Ombejeanne/PEIP2_Arduino_ExploBot/README.md

# PEIP2_Arduino_ExploBot
Le projet Arduino 2018 de Michele Bona et Anthony Barna.
