Ombejeanne/PEIP2_Arduino_ExploBot/documents/specs.md

# Caractéristiques des composants utilisés 

## Arduino UNO R3

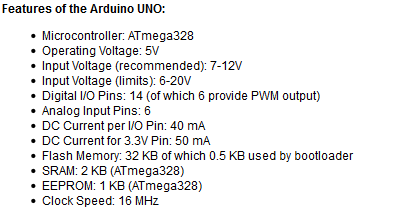
[picture p1: documents/images/Arduino UNO R3 specs.PNG]


## Commande d'entraînement de moteur à courant continu L298N 

* Alimentation intégrée : 5V
* Tension de pilotage : 7-35V
* Courant logique: 0mA-36mA 
* Tension logique: 5V 
* Courant d'entraînement: 2A 
* Tension d'entraînement: 5V-35V 
* Température de stockage: -20 à +135 
* Puissance maximum: 25W 

## Moteurs JGA 25 370

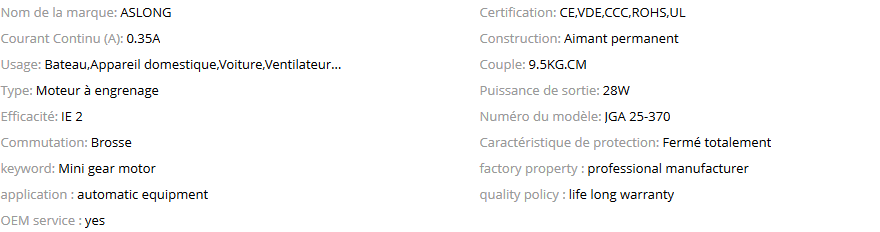
[picture p2: documents/images/moteur jga 25 370.PNG]


## Servomoteur Tower Pro MG 996R

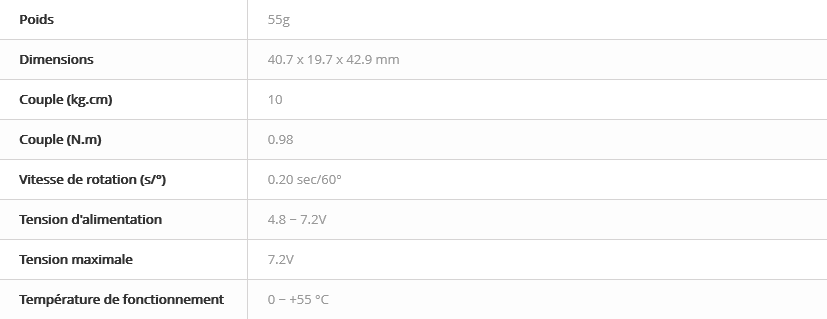
[picture p3: documents/images/Tower Pro MG 996 r.PNG]


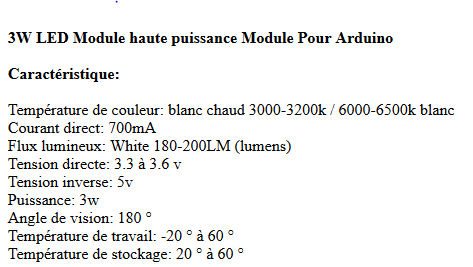
[picture p4: documents/images/LED HP 3W.PNG]
