Ombejeanne/PEIP2_Arduino_ExploBot/Rapports seances/Michele Bona.md

# Rapport Projet – Michele Bona

## 10/12/2018 – Premier jour :

* Notre groupe de projet est constitué de Michele Bona et Anthony Barna et on a aujourd’hui confirmé que notre projet sera l’ExploBot, une voiture « tout-terrain » (dans la mesure du possible) étudié pour explorer des grottes, des couloirs, les pyramides (avec lumières, caméra, détection d’obstacles, et autres à préciser plus tard).

* Je crée notre compte GitHub et lit le guide en ligne(https://guides.github.com/activities/hello-world/) pour bien comprendre comment on va s’organiser et on a récupéré une manette d’un ancien projet qui nous servira à diriger notre robot. Il faut par contre d’abord qu’on étudie comment elle marche, on a donc coupé et ressoudé les câbles de la manette qu’Anthony branchera sur sa carte Arduino pour étudier son fonctionnement.

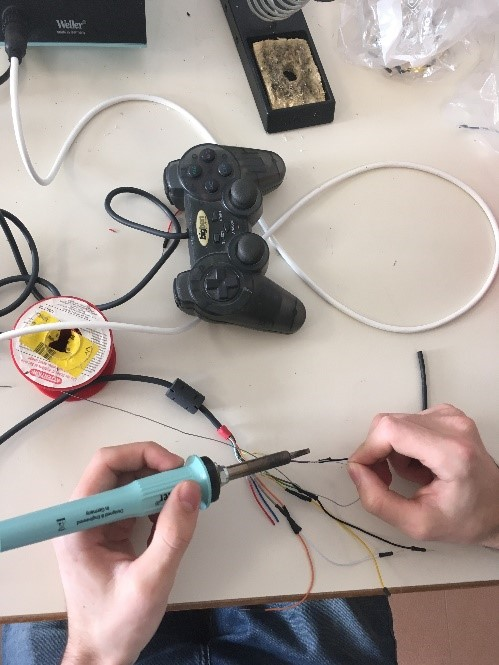
[picture p11: documents/images/ima.jpg]
Soudage cables, cf documents/images/ima.jpg

  
* Je fais des recherches sur le moteur dont on aura besoin selon le poids de notre robot, en effet on veut ajouter de nombreuses fonctionnalités à notre robot dont on n’a pas encore défini certaines donc on ne connait pas encore son poids et on doit commencer à étudier les puissances de moteurs dont on pourrait avoir besoin :

1. On s’est mit d’accord pour rester sur une base de 3 « fonctionnalités » (toutes dirigeables avec un servomoteur) : une caméra, de la lumière et un capteur de distance/d’obstacle.

2. J’ai cherché sur robotshop.com un outil de dimensionnement de moteur : https://www.robotshop.com/community/blog/show/dimensionnement-dun-moteur-dentranement
Je verrais la prochaine fois la dimension necessaire.

* Je fais notre cahier des charges avec un tableau excel, je fais les recherches pour voir ce dont j'aurais besoin pour le support et le moteur de la voiture et je vois combien de temps chaque élément du projet va prendre et je le rajoute au CDC au fur et à mesure.

## 17/12/2018 - Deuxième jour:

* J'ai été malade toute la semaine du 17 et est donc fait mes recherches pendant les vacances et ai perdu mon cahier des charges que j'ai donc refait.

* J'ai choisi les caracteristiques des moteurs nécessaire pour faire tourner nos roues en partant de l'idée que notre robot peserai au grand maximum 1kg (sachant que le servo pèse 55g, une pile de 12V environ 150g et en m'insiprant d'autres projets similaires). On cherche de plus à avoir un vehicule tout terrain, donc on sacrifie la vitesse maximale que j'ai estimé à 0.8 m/s et je choisi un assez grand rayon de roue (4cm). Et en prenant en plus en compte le fait  qu'on a 2 moteurs d'entrainement l'outil de dimensionnement de robotshop nous conseille un moteur avec un couplage de 0.1 Nm et de 2.2 W, ce qui me semble peu mais on peut dire que c'est un minimum et que plus de couplage ne nous fera pas de mal pour gravir des terrain compliqués.

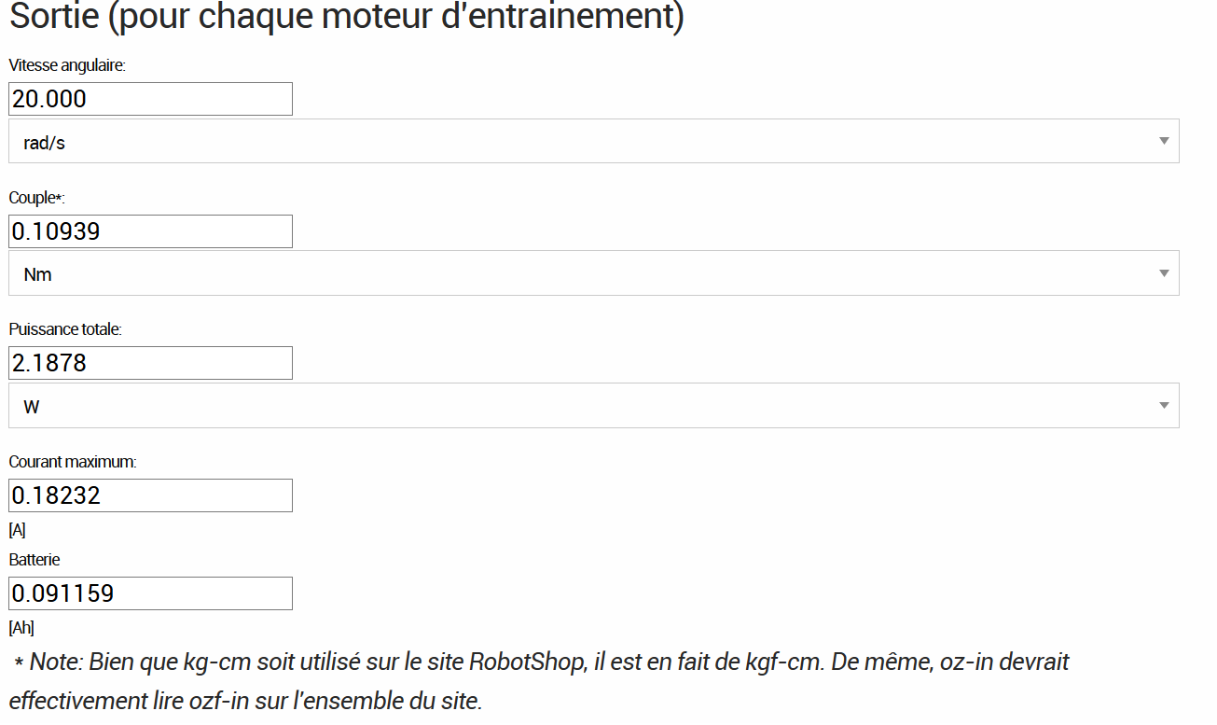
[picture p12: documents/images/carac_moteur.png]
Caractéristiques du moteur, cf documents/images/carac_moteur.png


* Pour les roues on veut des chenilles donc j'ai décidé de choisir 6 roues crantées de diamètre 4cm mais j'ai constaté qu'il faut que je sache la taille de l'axe moteur avant pour les choisir. Donc la semaine prochaine je vais commander les pièces nécessaires pour pouvoir choisir les dimensions du reste, l'ordre de choix est donc le suivant: moteur > axe moteur > roue crentées > batteries > toutes les pieces > chassis

## 7/01/2019 - Troisième jour:

* J'ai trouvé sur des projets similaires des moteurs utilisés d'environ 3 W qui peuvent avoir un couplage allant de 0.2 à 0.8 Nm, pour des projets moins lourds que le notre qui plus est... Donc le moteur de 2 W couplage de 0.1 Nm que j'ai trouvé avec l'outil de dimensionnement semble vraiment etre le minimum necessaire pour faire avancer notre robot...

* J'ai voulu regarder le projet de Dimitri de l'année dernière pour en étudier le moteur et on nous a dit qu'on pouvait commander un kit de chenilles + chassis + moteurs. Je vais donc en chercher un assez grand et avec des moteurs assez puissants.

* Jai fini par choisir ce modèle là: 
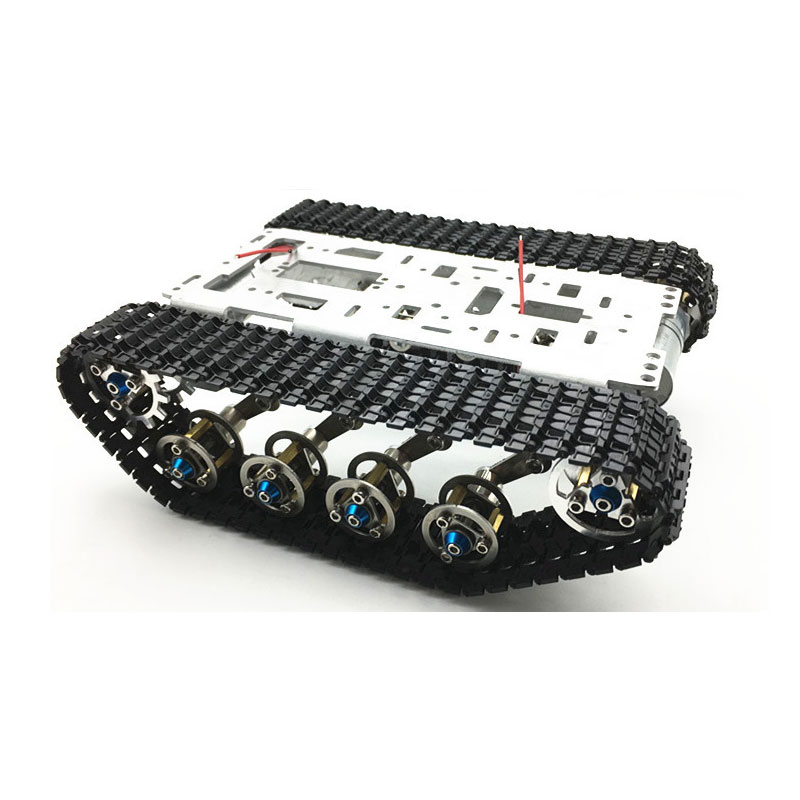
[picture p13: documents/images/porjetARD.jpg]
cf https://github.com/MicheleBona/PEIP2_Arduino_ExploBot/blob/master/documents/images/porjetARD.jpg

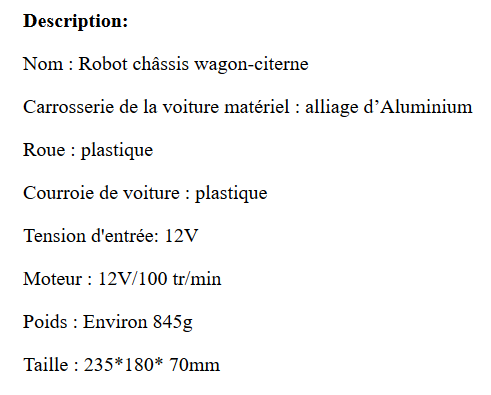
[picture p14: documents/images/Capture_projARD.PNG]
https://github.com/MicheleBona/PEIP2_Arduino_ExploBot/blob/master/documents/images/Capture_projARD.PNG


https://www.ebay.fr/itm/A-FAIRE-SOI-MEME-RC-Smart-Robot-Tank-Sur-chenilles-Car-Chassis-Kit-avec-Crawler/282905756754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

* On voulait un chassis de 20cm fois 15cm environ et celui-ci est un peu plus grand, les carastéristiques des moteurs inclus sont bien compatibles avec la commande d'entraînement de moteur à courant continu L298N, le sytème de roues + chenilles est déjà installé, tout ça est parfait. Le seul soucis est que c'est un peu lourd mais les moteurs font 100tr/min et le robot complet ne devrait pas dépasser 1.5kg ont aura tout de même un excellent couplage.

* Ceci étant fait j'ai commencé à réfléchir à la suite, j'ai vu comment d'autres projets programmaient les déplacement de robot à chenilles et j'ai refait le cahier des charges proprement sur les 9 semaines.

## 14/01/2019 - Quatrième jour:

* J'ai commencé le programme pour déplacer le robot, j'ai déjà fait le code de base qui permet de faire avancer les moteurs et je vais maintenant continuer pour faire avancer les moteurs selon la position d'un joystick que j'imagine codé sur 1 octet (donc avec des valeurs de 0 à 255 sur X,Y et la vitesse gérée par le deuxième joystick).

* J'ai fait des graphiques représentant les valeurs des joysticks pour m'aider avec mon code:
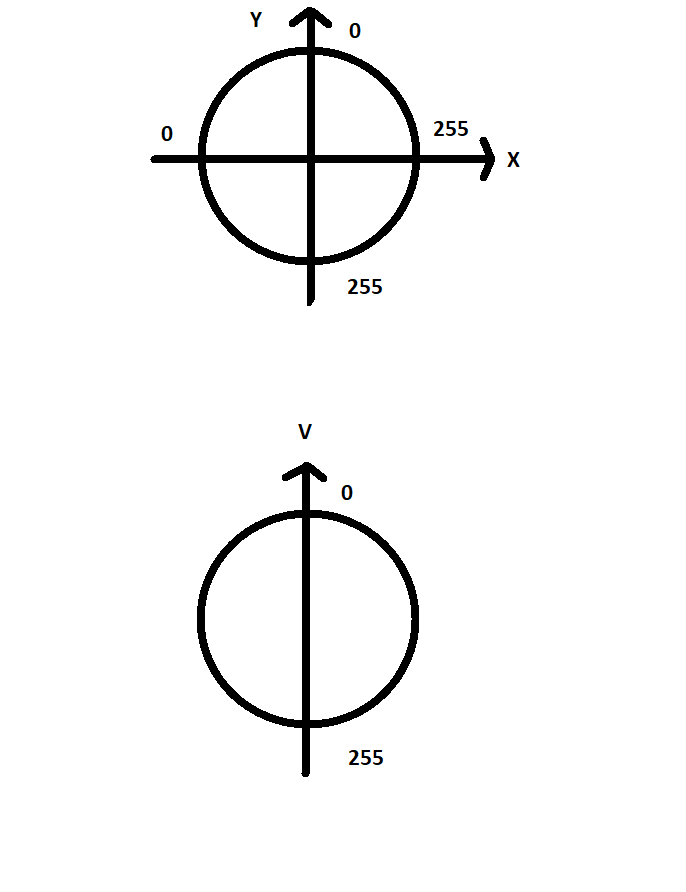
[picture p15: documents/images/ValeurJoy.png]
cfhttps://github.com/MicheleBona/PEIP2_Arduino_ExploBot/blob/master/documents/images/ValeurJoy.png


* J'ai décidé le mode de déplacement: le joystick gauche choisi la direction (avant, arriere, gauche, droite, arriere gauche,...) et le droit la vitesse (de la position au repos v=0 à la position completement en haut v=255). J'ai vu une vidéo d'un char controlé par ce système qui est très maniable et permet un très bon déplacement.

* Pour faire un code le plus propre possible pour Anthony je m'y prends par étape, en commençant par le déplacement avant/arrière, et je crée des fonctions pour chaque déplacement pour que la loop soit la moins chargée possible et donc plus lisible. De plus un tel programme me permettra de rajouter des mouvements plus complexes facilement après avoir fait les bases du déplacement (tourner à l'arrêt, se retourner,...).

* Finalement le code est très propre et lisible, le déplacement avant/arrière marche et j'ai commencer le déplacement sur 2 axes.

## 04/02/2019 - Cinquième jour:

* On a reçu le char et je vais passer la séance à le monter, il n'y a pas de guide fourni avec donc je cherche un guide pour l'assemblage sur internet.

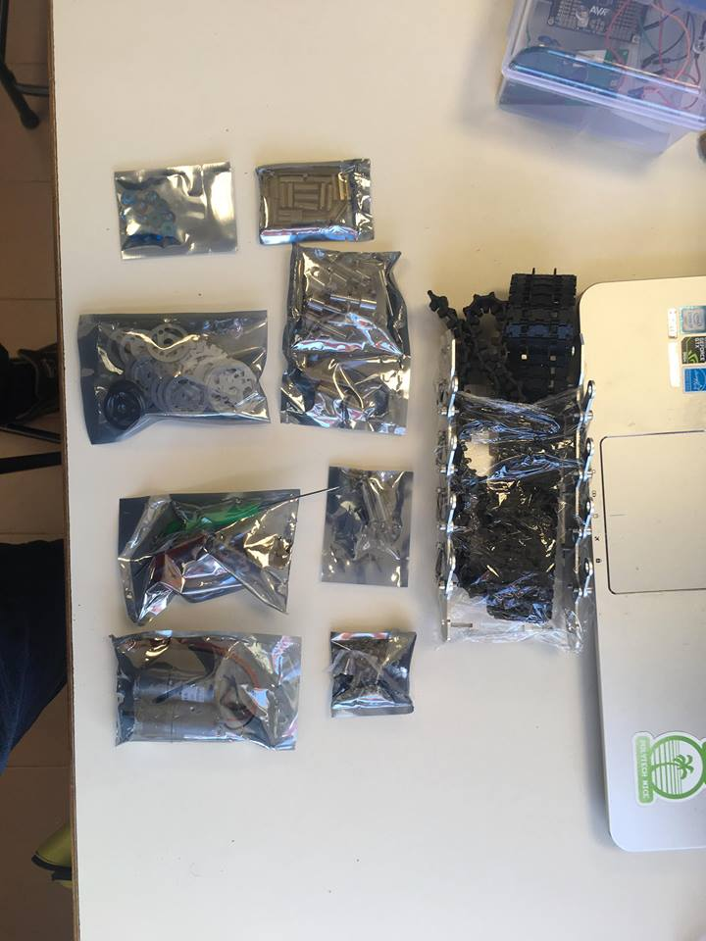
[picture p16: documents/images/assemblage.jpg]
https://github.com/MicheleBona/PEIP2_Arduino_ExploBot/blob/master/documents/images/assemblage.jpg


* J'ai trouvé une vidéo d'un particulier qui a monté le même modèle (https://www.youtube.com/watch?v=-9WLhvXwGhw) mais pas de réel guide donc je dois me débrouiller avec cette vidéo et les photos pour le montage mais c'est assez logique.

* J'ai réussi à monter une roue et je sais comment monter les moteurs, donc il ne me reste plus qu'à les monter...
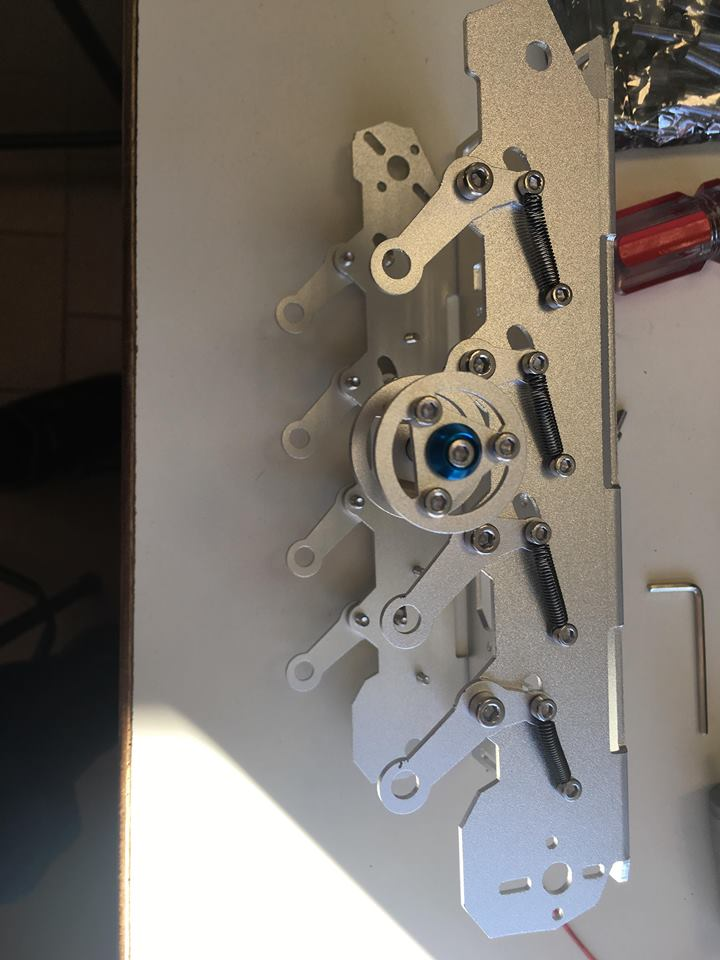
[picture p17: documents/images/roue.jpg]
https://github.com/MicheleBona/PEIP2_Arduino_ExploBot/blob/master/documents/images/roue.jpg


* J'ai monter toutes les roues, un moteur, une roue motrice et une chenille. Pour inserer la roue motrice dans l'axe moteur j'ai besoin de mettre de la colle car le système prévu dans le kit ne marche pas je ferais donc les deuxiemes roue motrice et chenille la prochaine séance.

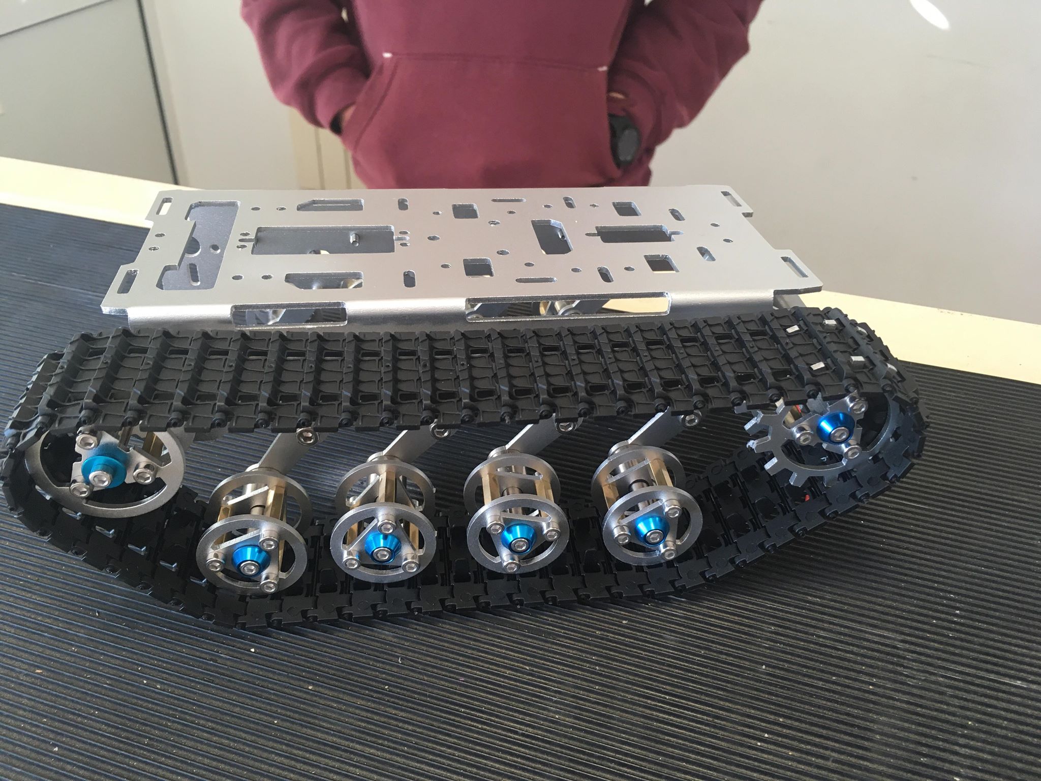
[picture p18: documents/images/char.jpg]
https://github.com/MicheleBona/PEIP2_Arduino_ExploBot/blob/master/documents/images/char.jpg


## 11/02/2019 - Sixième jour:

* Je vais commencer par finir le char, j'ai commencé par ressouder un cable sur le moteur qui est tombé.

* en attendant que Anthony finisse de tester les moteurs et la carte je décide de continuer le code de ses déplacements.

* Le char est presque terminé, j'ai encore un probleme pour bloquer une piece sur l'axe moteur vu que le système prévu dans le kit ne tient pas du tout même en ajoutant de la colle sur la vis. Ducoup je vais essayer de mettre directement la colle sur l'axe, et si ça ne tient toujours pas j'irai au Fablab pour faire un trou dans l'axe moteur et y mettre une vis longue...
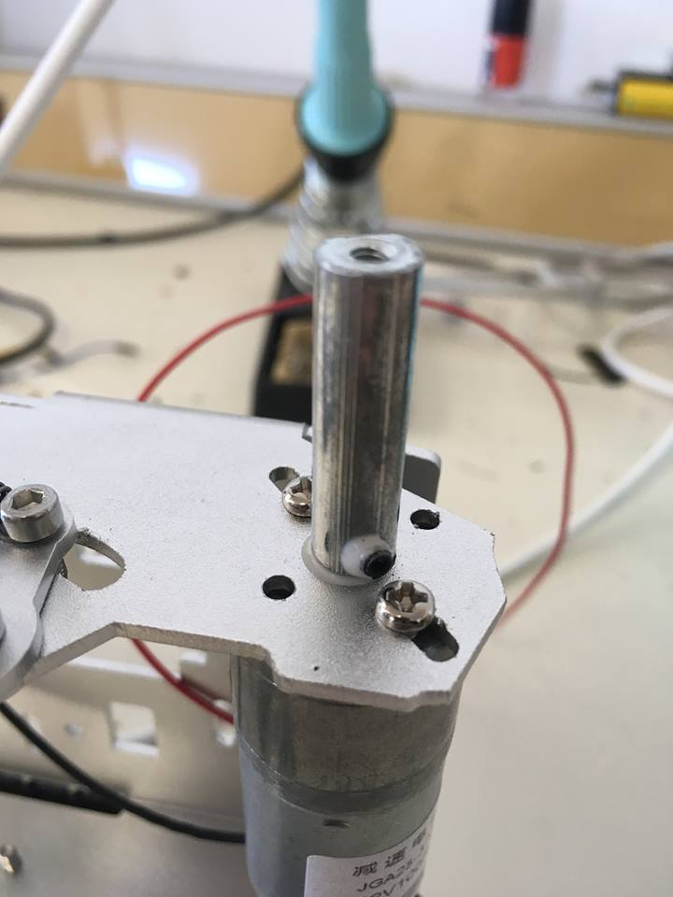
[picture p19: documents/images/axe moteur.jpg]
https://github.com/MicheleBona/PEIP2_Arduino_ExploBot/blob/master/documents/images/axe%20moteur.jpg

 
 * Ca ne marche toujours pas je vais donc au Fablab voir qu'elles solutions ils ont à me proposer.

## 25/02/2019 - Septième jour:

* Le char est complet et solide et le code terminé, on va maintenant tester notre code pour déplacer le char.

* Le code semble fonctionnel mais un seul moteur du char marche... On teste en changeant de câbles et de sens les moteurs mais le problème subsiste, on vérifie avec l'ocsilloscope et c'est les ports IN3 et IN4 qui restaient à 0. On final il étaient mit dans de mauvaise entrées sur l'arduino...

* On installe maintenant tout sur le char (arduino et pont en H) et on gère les câbles au mieux. On a soudé les différentes masses ensemble et les différentes alim 3.3 V ensemble. 

## 04/03/2019 - Huitième jour:

* Je crée le support en bois qu'on va fixé sur notre char.
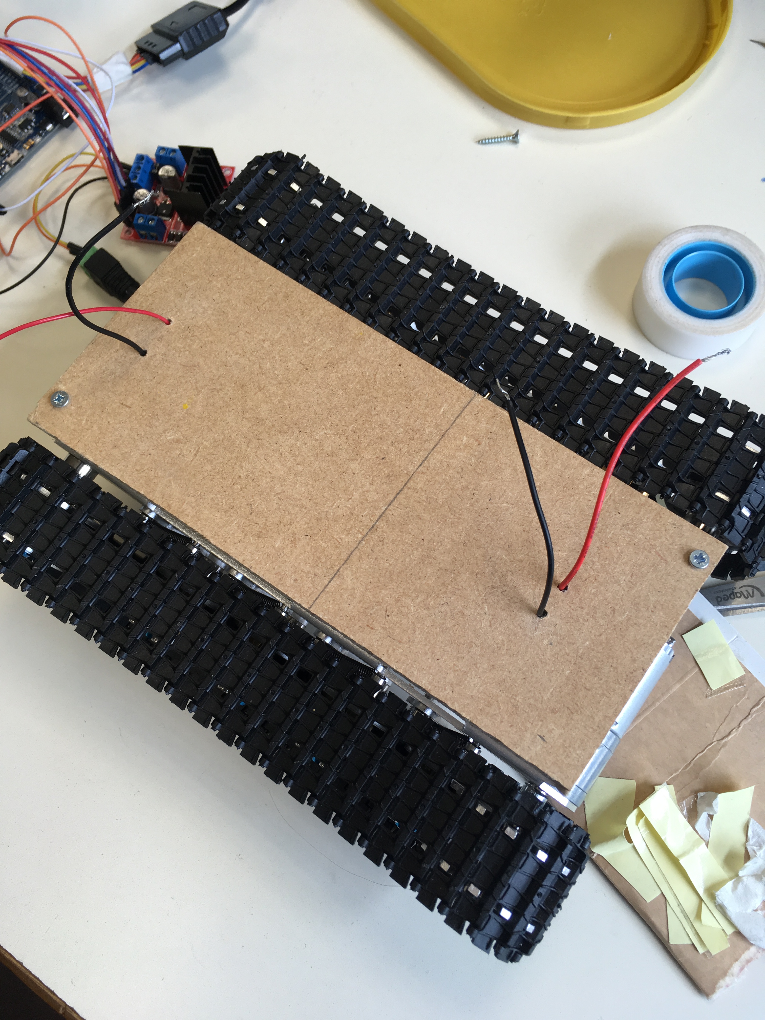
[picture p20: documents/images/support.jpg]
https://github.com/MicheleBona/PEIP2_Arduino_ExploBot/blob/master/documents/images/support.jpg


* On a remplacé la carte pour une UNO et fixé la carte, le pont en H, l'alimentation, la bout de la manette, on a fait du cable management et il reste plus qu'à fixer la batterie (auquel on a ajouté des scratches), la caméra (qu'on a testé et qui marche) et la lampe.

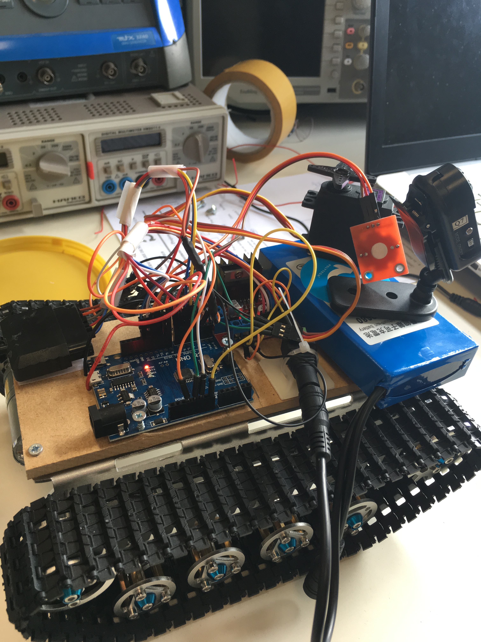
[picture p21: documents/images/explobot_cameraservo.jpg]
https://github.com/MicheleBona/PEIP2_Arduino_ExploBot/blob/master/documents/images/explobot_cameraservo.jpg


* L'explobot est maintenant operationel et presque complet, on ajoutera les details manquant et les finitions dans la semaine...
