Ombejeanne/PEIP2_Arduino_ExploBot/documents/CDC_2.0.png

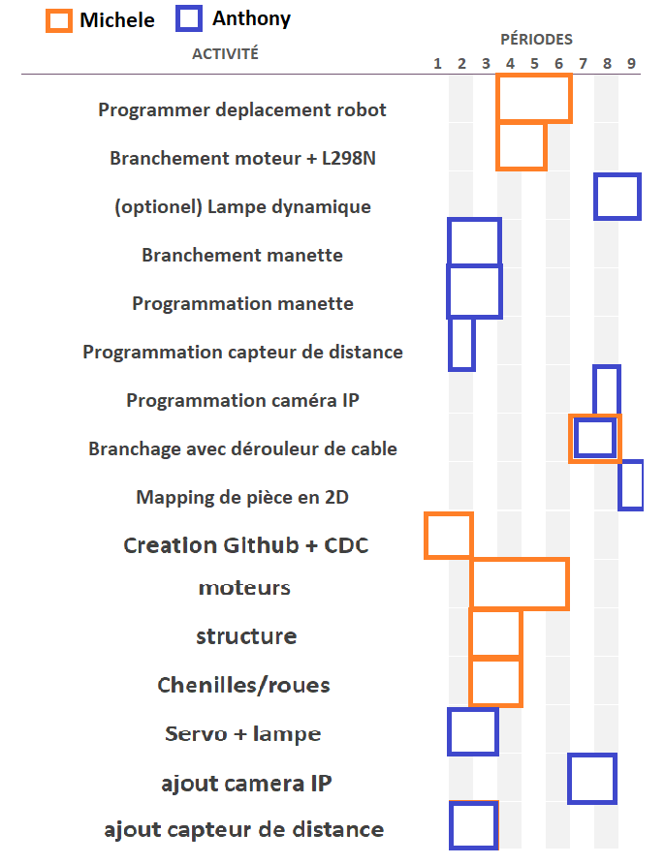
documents/CDC_2.0.png
